hospadar/ShutterSpeedCalibrator/(commit log)

2026-09-28 Polaroid board: fix R4/R5 reference divider and USB-C CC resistors
    - R4/R5: the PCB routes R4 from GND to U1+ and R5 from U1+ to +5V, but
    the schematic had them the other way round (and the PCB footprints
    linked to deleted symbols, so parity matched by reference only). With
    the schematic values as routed, U1+ sat at ~4.9 V and the photodiode
    amp was saturated. The schematic now matches the routed copper: R4
    (6.8k) is on the GND side and R5 (330k) on the +5V side, giving
    ~0.10 V at U1+, which is what the firmware's dark threshold expects.
    The PCB footprints are relinked to the current symbols. Copper is
    unchanged.
    - R6/R7 (USB-C CC1/CC2 pull-downs): 1k / not fitted -> 5.1k / 5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
    [ShutterCal_Polaroid.kicad_pcb, ShutterCal_Polaroid.kicad_sch]
2026-09-28 Polaroid board: match ordered parts; add JLC assembly files
    - Values now name the parts ordered: C1 0.75pF, R1 240k, U1
    OPA365AIDBVR, F1 0.5A PPTC.
    - R2 91k -> 100k (JLC basic part). The ADC divider ratio changes from
    0.622 to 0.600, so the max input is 3.15 V at 5.25 V. The firmware only
    uses relative thresholds.
    - production_jlc/: BOM with LCSC numbers and CPL (bottom-side
    assembly). The rotations were checked against JLC's footprint for
    every part.
    [BOM_JLC.csv, ShutterCal_Polaroid.kicad_pcb, ShutterCal_Polaroid.kicad_sch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]
